pawl/Rod-Assisted-Design-OpenSCAD/(commit log)

2026-08-22 Fix spacer/panel mount screws never generating
    The screwAngleList refactor removed the screwEnable variable but spacermount() still checks it in three places, so OpenSCAD warns about an unknown variable and the documented tab screw hole is silently skipped. Use the same len(screwAngleList) > 0 test dowelhole() already uses.
    [Rod Assisted Design Customizer.scad]
2026-08-22 Improve Customizer panel usability
    [Rod Assisted Design Customizer.scad]
2026-08-24 Fix spacer/panel mount screws never generating
    Commit 97e685b removed the screwEnable variable when screw enabling
    moved to screwAngleList, but spacermount() still checks screwEnable in
    three places. OpenSCAD warns "Ignoring unknown variable 'screwEnable'"
    three times per render and the documented tab screw hole and
    countersink/counterbore are silently skipped on every spacer/panel
    mount export.
    Restore screwEnable as a derived value implementing the documented
    behavior: screws are enabled when screwAngleList is populated.
    Claude-Session: https://claude.ai/code/session_01VFe5NJ24BntZ9F7E71iYh5
    [Rod Assisted Design Customizer.scad]
2026-08-24 Fix non-manifold geometry from coincident faces
    Two exact-coincidence contacts made F6 renders warn 'Object may not be
    a valid 2-manifold and may need repair', including on the default
    connector parameters, and could export meshes with edges shared by
    four faces:
    - The rib base sits exactly on the flattened leg top (and exactly
    tangent to the round top when flatTopEnable is off). Sink ribs 0.1mm
    into the body so the contact is a proper volume overlap and the rib
    fuses to the leg in both cases.
    - Countersink and counterbore pockets end exactly on the dowel bore
    surface when their depth equals the wall (thickness - screwDepth).
    Extend the pockets 0.02 so they pierce the bore instead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
    [Rod Assisted Design Customizer.scad]
2026-08-24 Add Customizer group headers and dropdowns, fix comment typos
    Comment-level changes only: the parameter section banners become
    OpenSCAD Customizer group headers, enum-style parameters get dropdown
    annotations (part type, stoppers, on/off toggles, skadis orientation),
    and several comment typos are fixed. No geometry change: volume, area,
    and bounding box are identical for all four part types.
    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
    [Rod Assisted Design Customizer.scad]
2026-08-24 Add optional net anchor tie-off lug to the connector
    A default-off lug on the center leg with a teardropped tie hole for
    attaching netting, twine, cord, or zip ties, so nets no longer have to
    be zip-tied around the tubes themselves. The lug is a vertical blade
    that always extends to the flat bottom plane, so it prints support-free
    in the normal flat bottom orientation and keeps pull loads in the plane
    of the printed layers. Its root stops halfway into the center leg wall,
    so no angle can break into the dowel bore; the angle, hole diameter,
    and hole height parameters position it clear of legs, ribs, and screw
    holes (defaults clear the default connector).
    With netAnchorEnable=0 (the default)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
    [Rod Assisted Design Customizer.scad]
2026-08-24 Drop the screwEnable shim, check screwAngleList directly
    The spacer screw fix resurrected screwEnable as a derived variable, but
    dowelhole() already checks len(screwAngleList) > 0 directly - the
    refactor in 97e685b deleted the variable on purpose. Finish that
    refactor instead: the three spacermount() checks use the same list test
    and the shim goes away.
    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
    [Rod Assisted Design Customizer.scad]
2026-08-24 Make Customizer parameter descriptions display correctly
    The Customizer shows only the last comment line above a variable, so
    multi-line parameter comments lose everything but their final line and
    several parameters display no description of what they actually do:
    flatBottomDepth and flatTopDepth show only "Keep this under thickness
    value", skadisTab loses "adds a Ikea Skadis capable hook", and
    screwAngleList shows "screwAngle = 0;" because a commented-out line
    sits between it and its documentation.
    Join each parameter's comment into a single line and drop the stale
    //screwAngle = 0; line left over from the screwAngleList refactor.
    Comments only - all four part types render identical geomet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
    [Rod Assisted Design Customizer.scad]
2026-08-29 Fix non-manifold geometry from coincident faces
    Two places where solids meet exactly rather than overlapping, which
    makes F6 report "Object may not be a valid 2-manifold and may need
    repair" and can export meshes with edges shared by four faces:
    - The rib base sits exactly on the flattened leg top, and exactly
    tangent to the round top when flatTopEnable is off. Sink ribs 0.1mm
    into the body so the contact is a volume overlap and the rib fuses to
    the leg in both cases.
    surface when their depth equals the wall, thickness - screwDepth.
    Extend them 0.02 so they pierce the bore instead.
    Both are the usual epsilon-over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
    [Rod Assisted Design Customizer.scad]
2026-08-29 Derive the overlap epsilon instead of hardcoding it
    Replaces the hardcoded 0.02 and 0.1 from the previous commit with a single
    named value, overlap = thickness/100, so it scales with the model instead of
    assuming millimetre-sized parts.
    The countersink/counterbore placement also gets two named locals, pocketRadius
    and pocketDepth. The old expression divided the whole sum by 2, so the epsilon
    had to be written as double what it actually applied, which made it impossible
    to read off what the overlap really was.
    Both contacts still need the overlap under either geometry backend, for
    different reasons:
    - CGAL reports "may not be a valid 2-manifold" when the rib base is coplanar
    with the leg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
    [Rod Assisted Design Customizer.scad]
